rcostache230/magic-8-ball/assets/answers_sheet.png

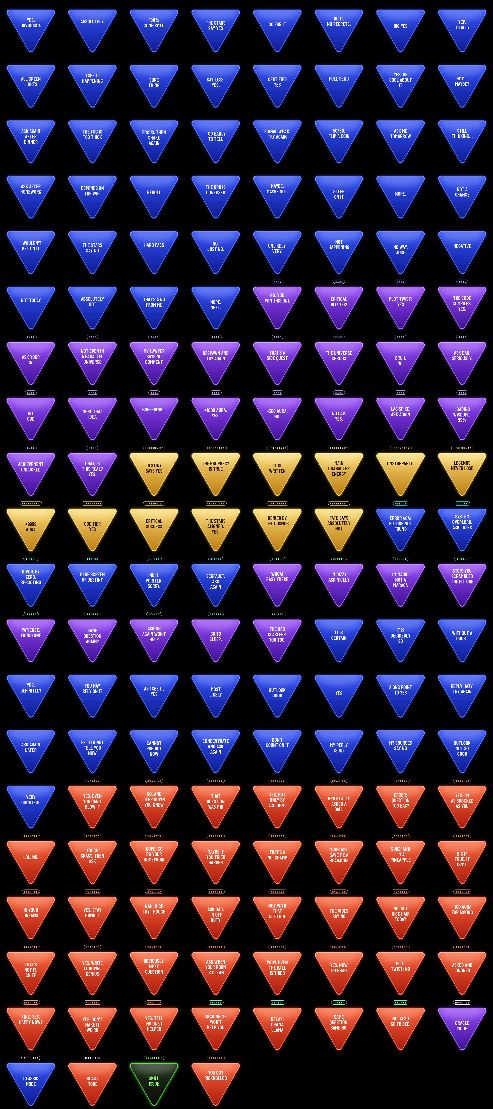
assets/answers_sheet.png
