rcostache230/magic-8-ball/assets/die/die_00.png

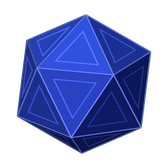
assets/die/die_00.png
