rcostache230/magic-8-ball/assets/die/die_01.png

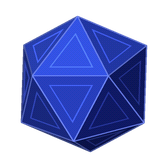
assets/die/die_01.png
