rcostache230/magic-8-ball/assets/die/die_02.png

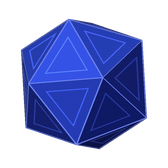
assets/die/die_02.png
