rcostache230/magic-8-ball/assets/die/die_03.png

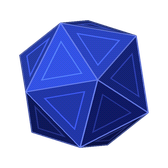
assets/die/die_03.png
