rcostache230/magic-8-ball/assets/die/die_04.png

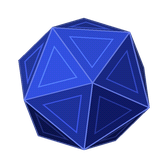
assets/die/die_04.png
