rcostache230/magic-8-ball/assets/die/die_05.png

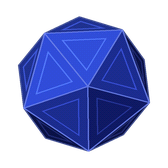
assets/die/die_05.png
