rcostache230/magic-8-ball/assets/die/die_07.png

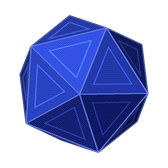
assets/die/die_07.png
