rcostache230/magic-8-ball/assets/die/die_09.png

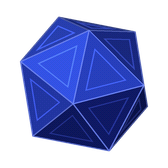
assets/die/die_09.png
