rcostache230/magic-8-ball/assets/die/die_11.png

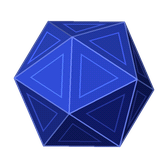
assets/die/die_11.png
