rcostache230/magic-8-ball/assets/die/die_12.png

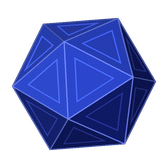
assets/die/die_12.png
