rcostache230/magic-8-ball/assets/die/die_14.png

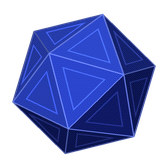
assets/die/die_14.png
