rcostache230/magic-8-ball/assets/die/die_15.png

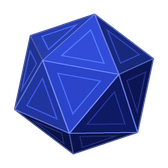
assets/die/die_15.png
