rcostache230/magic-8-ball/assets/die_sheet.png

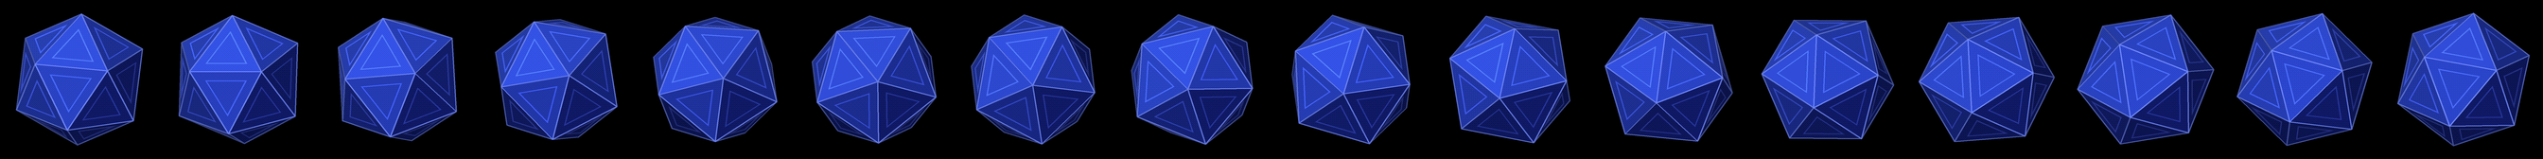
assets/die_sheet.png
