rcostache230/magic-8-ball/assets/disc8.png

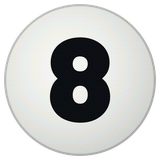
assets/disc8.png
