rcostache230/magic-8-ball/assets/disc8_roast.png

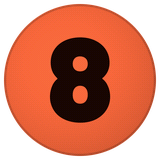
assets/disc8_roast.png
