rcostache230/magic-8-ball/assets/preview.png

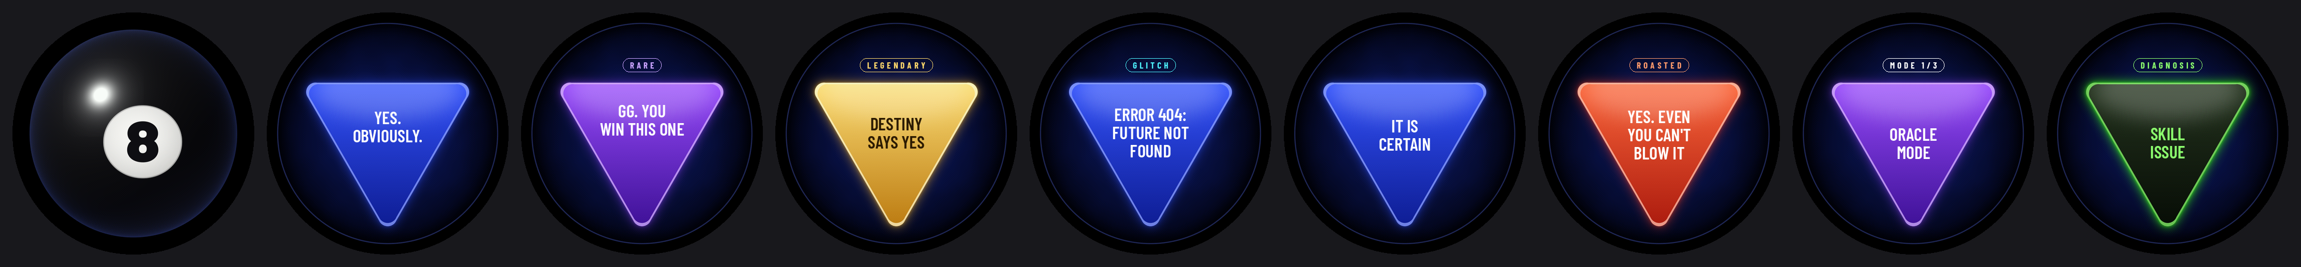
assets/preview.png
