rcostache230/magic-8-ball/assets/spec.png

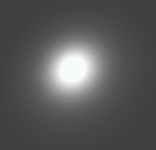
assets/spec.png
