rcostache230/magic-8-ball/assets/sphere.png

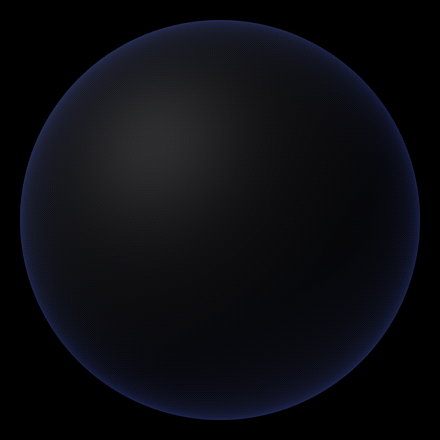
assets/sphere.png
