rcostache230/magic-8-ball/assets/tri_blue.png

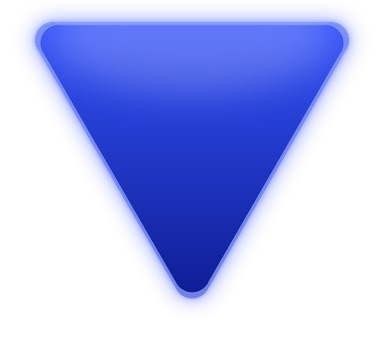
assets/tri_blue.png
