rcostache230/magic-8-ball/assets/window.png

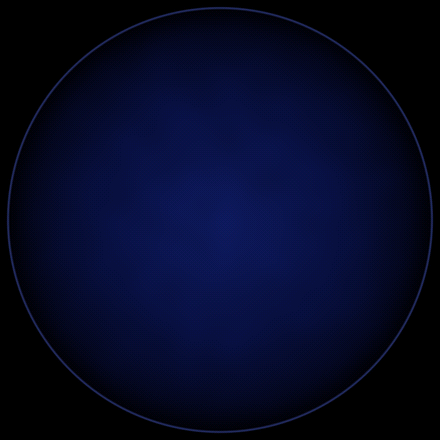
assets/window.png
