rcostache230/magic-8-ball/case/out/preview-face.png

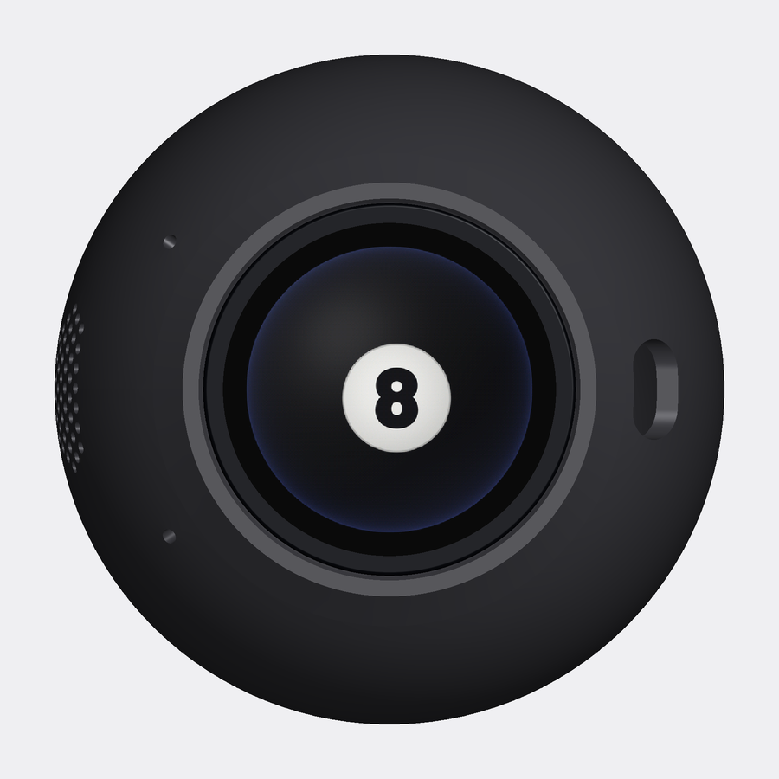
case/out/preview-face.png
