rcostache230/magic-8-ball/case/out/preview-side.png

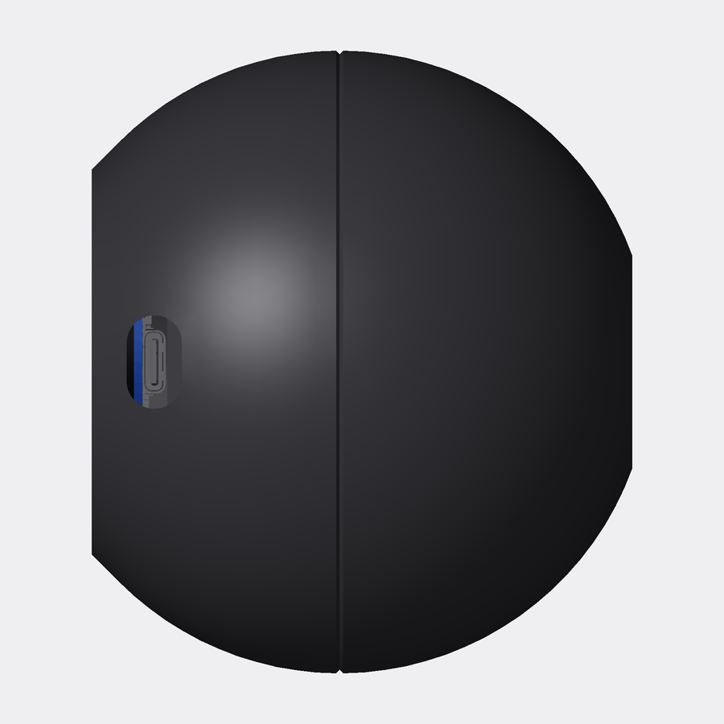
case/out/preview-side.png
