rcostache230/magic-8-ball/docs/screens/gallery.png

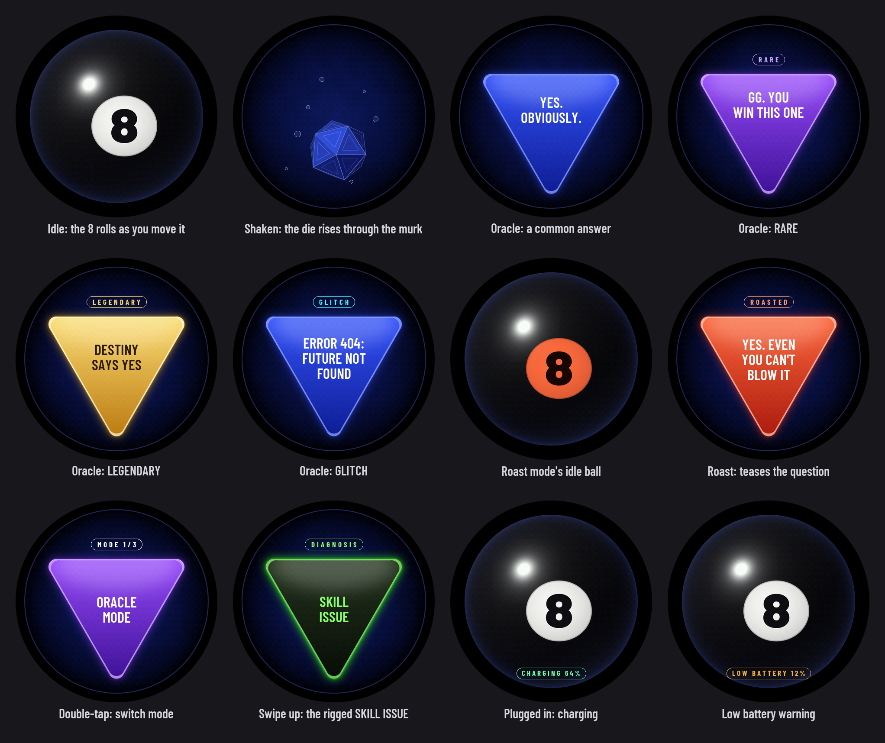
docs/screens/gallery.png
