rcostache230/magic-8-ball/case/out/assembly.step

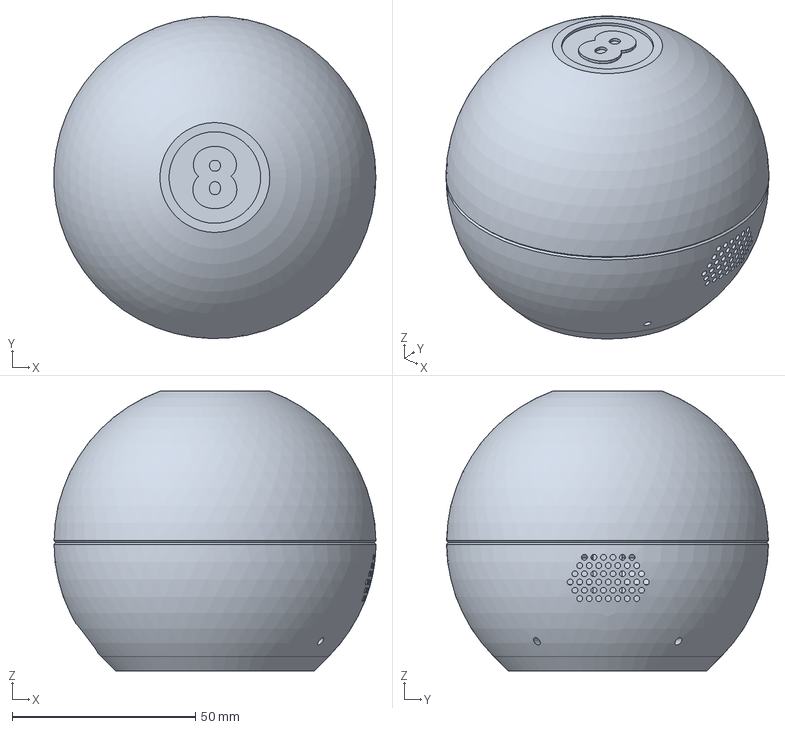
[picture p42: CAD file, 2026-11-09]
case/out/assembly.step
87.9 x 88.0 x 76.4 mm
