rcostache230/magic-8-ball/case/out/front.stl

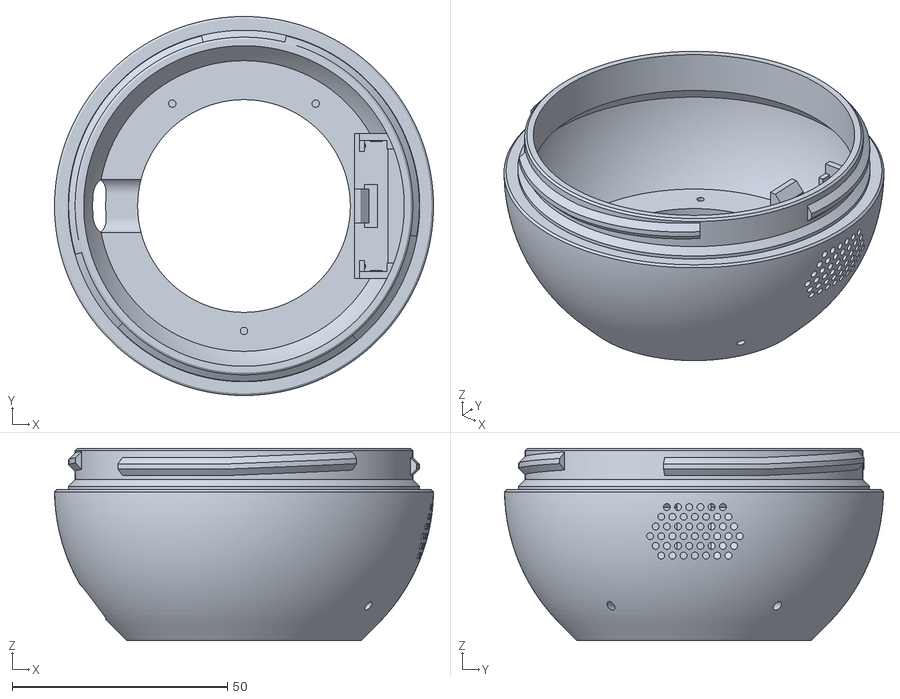
[picture p43: CAD file, 2026-11-09]
case/out/front.stl
88.0 x 88.0 x 44.6
