rcostache230/magic-8-ball/case/out/cap.stl

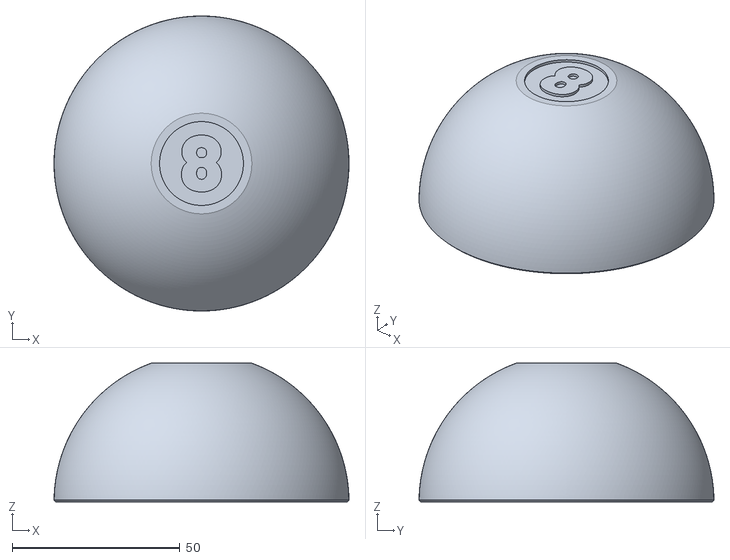
[picture p44: CAD file, 2026-11-09]
case/out/cap.stl
88.0 x 88.0 x 41.4
