rcostache230/magic-8-ball/case/out/magic-8-ball-case.3mf

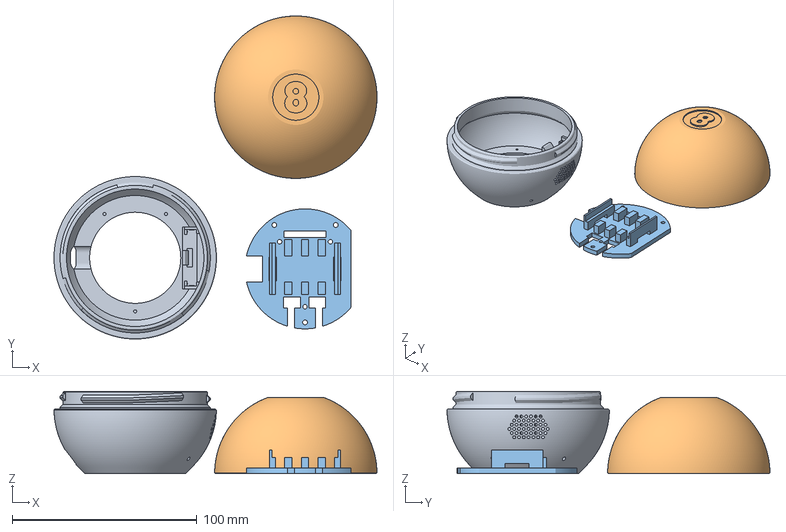
[picture p45: CAD file, 2026-11-09]
case/out/magic-8-ball-case.3mf
175.0 x 175.0 x 44.6 mm
