rcostache230/magic-8-ball/case/out/fit-test-coupons.3mf

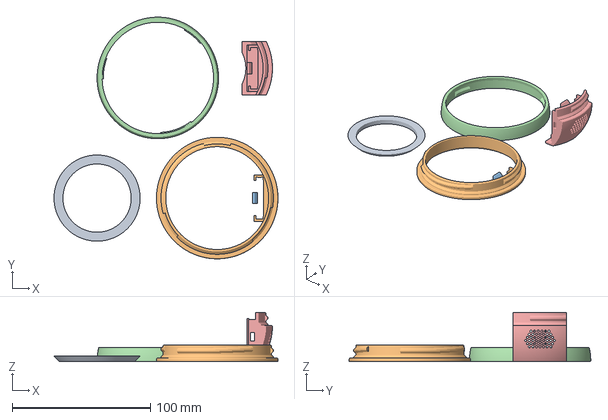
[picture p46: CAD file, 2026-11-09]
case/out/fit-test-coupons.3mf
162.2 x 175.0 x 35.6 mm
