rcostache230/magic-8-ball/case/out/carrier.stl

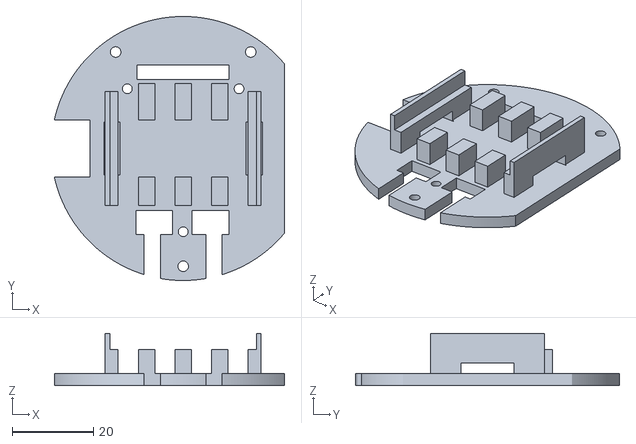
[picture p47: CAD file, 2026-11-09]
case/out/carrier.stl
56.7 x 65.0 x 12.9
