rcostache230/magic-8-ball/(commit log)

2026-11-09 Magic 8 Ball for the Waveshare ESP32-S3-Touch-AMOLED-1.75
    ESPHome firmware with three answer modes (Oracle, Classic, Roast), rarity
    tiers, easter eggs, secret swipe gestures, synthesized sounds, battery
    management with motion wake, and a microSD video player. Includes the
    parametric 3D-printed case (twist-lock shell, speaker sleeve, battery strap),
    the asset and sound generators, and a MakerWorld listing kit.
    Code: MIT. Case model and art: CC BY-NC-SA 4.0.
    [assembly.step, cap.stl, carrier.stl, fit-test-coupons.3mf, front.stl, machine.json, magic-8-ball-case.3mf]
2026-11-09 Add a screen gallery, link the Waveshare board, mark case v2 as printed
    - tools/make_screens.py draws twelve screen states (idle, asking, each answer
    tier, Roast mode, mode card, SKILL ISSUE, charging, low battery) from the
    firmware's own art and layout into docs/screens/, plus a captioned gallery.png.
    - README: a Screens section, case renders, links to Waveshare's product page.
    - case/README: v2 (speaker sleeve, battery strap, moved frame screws) is now
    printed and assembled, and everything fits.
    [make_screens.py]
